michelm63/AEMM/AEMM24-02-2017.pdf

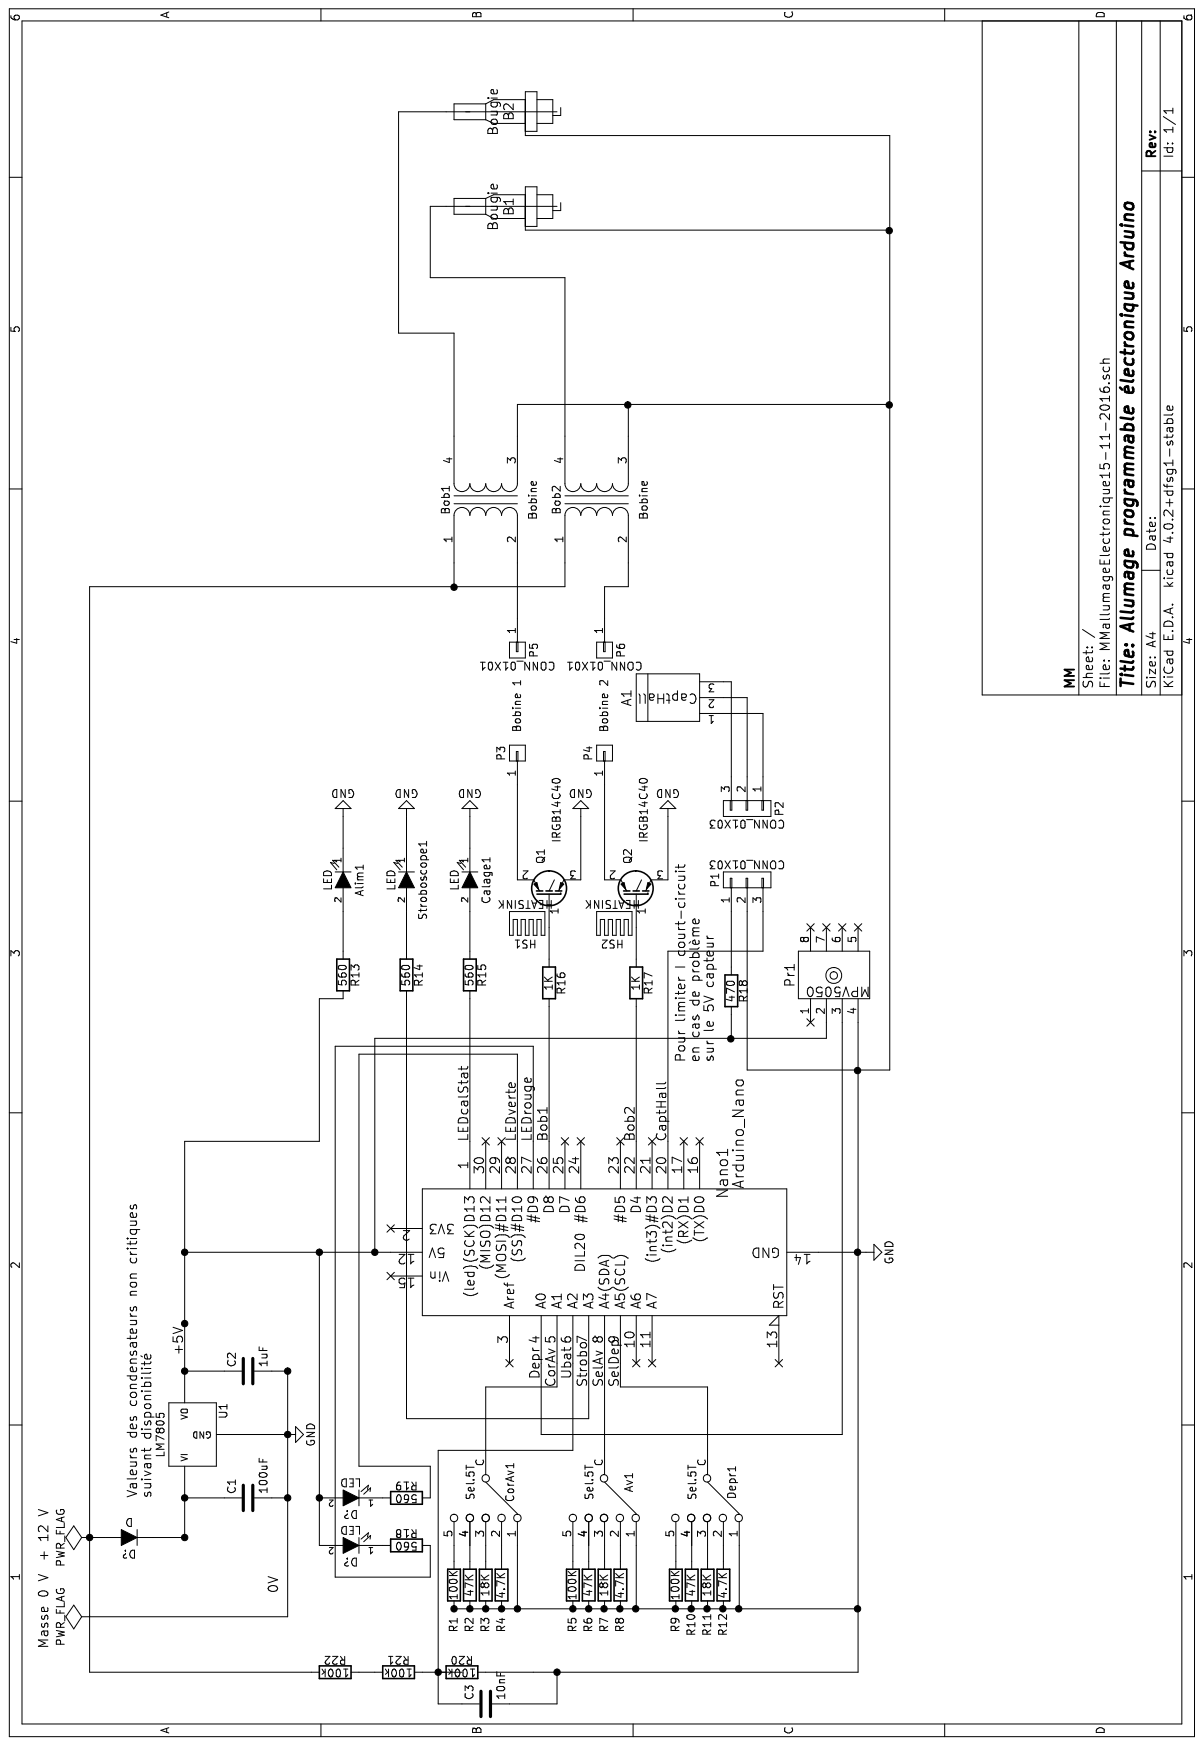
[picture p1: page 1]
