michelm63/AEMM/(commit log)

2017-03-04 Create AEMM-Multi-Cible-Simple-03-03-2017
    Cette version est avec une cible simplifiée (déclenchement à 60° vilebrequin avant le Point Mort Haut à 0°).
    L'avance au démarrage au kick est calculée, pas fixée par la fin de cible à 0° (PMH).
    L'avance entre Ndem et Nplancher est fixe à 5° (meilleure stabilité) et non modifiable (sélecteur, courbe etc.)
    Le temps de charge bobine est fixe et stable sur toute la plage de régime moteur (0 à 7000 tr/mn)
2018-02-19 Create AEMM-Me-Ub-Nk-C72-19-02-2018
    Me multi-étincelles d'allumage
    Ub Tension batterie
    Nk démarrage au kick
    C72 Cible de 72° vilebrequin
2018-02-19 Create Simulateur générateur de signaux ducapteur moteur
2018-02-25 Create AEMM-CDI-Me-Nk-C72-25-02-2018
    Allumage version CDI (allumage à décharge de condensateur)
2018-10-13 Create AEMM-Me-Ub-Nk-C72-12-10-2018
    Version avec choix Dwell 1 ou 2 pour un temps de charge bobine correct sans ratés d'allumage vers 2200 tr/mn
2018-10-13 Create AEMM-Me-Ub-Nk-C72-13-10-2018
    Essai avec modification Dwell 3, majoration du temps de charge bobines sous un seuil défini du régime moteur
